kamtar/HotDogBalloon/hw/kicad_project/picoballoon.pdf

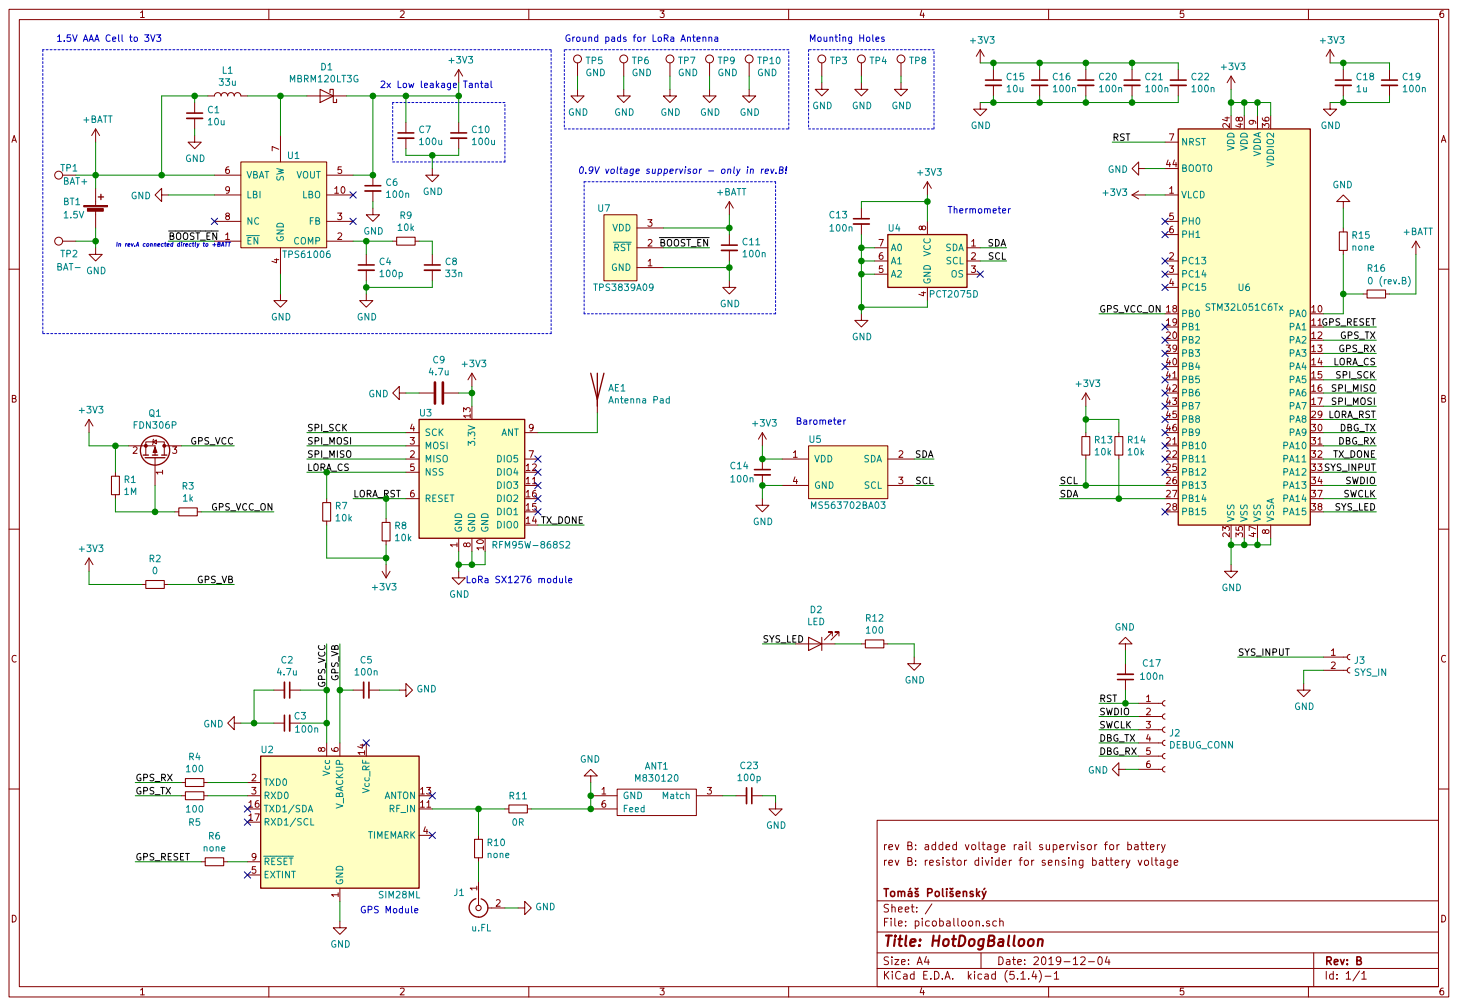
[picture p1: page 1]

9 VDDIO2 36 VLCD 1 VSS 23 VSS 35 VSS 47 VSSA

1 GND 10 DIO3 11 DIO4 12 3.3V 13 DIO0 14 DIO1 15 DIO2 16 MISO 2 MOSI 3 SCK 4 NSS 5 RESET 6 DIO5 7 GND

1 RF_IN 11 ANTON Vcc_RF 13 14 TXD1/SDA 16 RXD1/SCL 17 TXD0 2 RXD0 3 TIMEMARK 4 EXTINT 5 V_BACKUP

rev B: added voltage rail supervisor for battery GND

rev B: resistor divider for sensing battery voltage

File: picoballoon.sch Sheet: / Tomá Polienský
