kamtar/HotDogBalloon/hw/kicad_project/picoballoon.kicad_pcb

## KiCad design hw/kicad_project/picoballoon.kicad_pcb (2019-12-02)

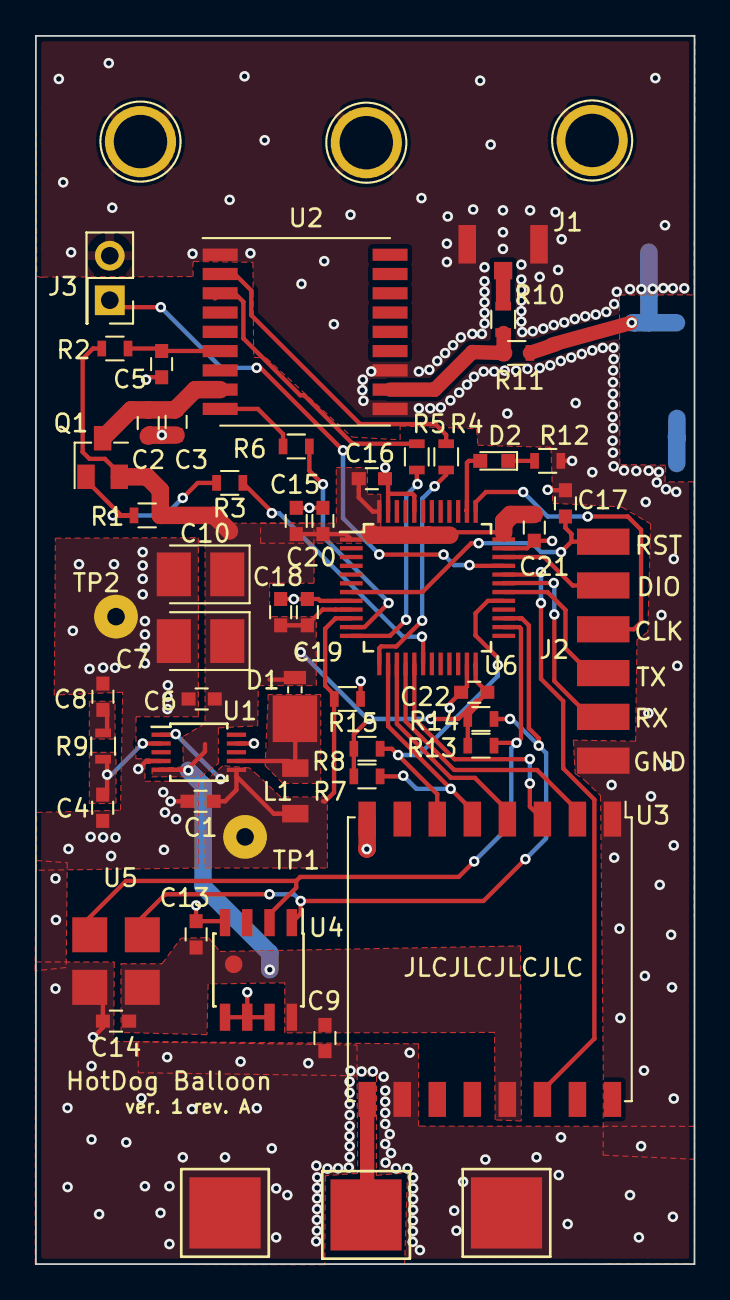
[picture p2: board picoballoon.kicad_pcb from above]

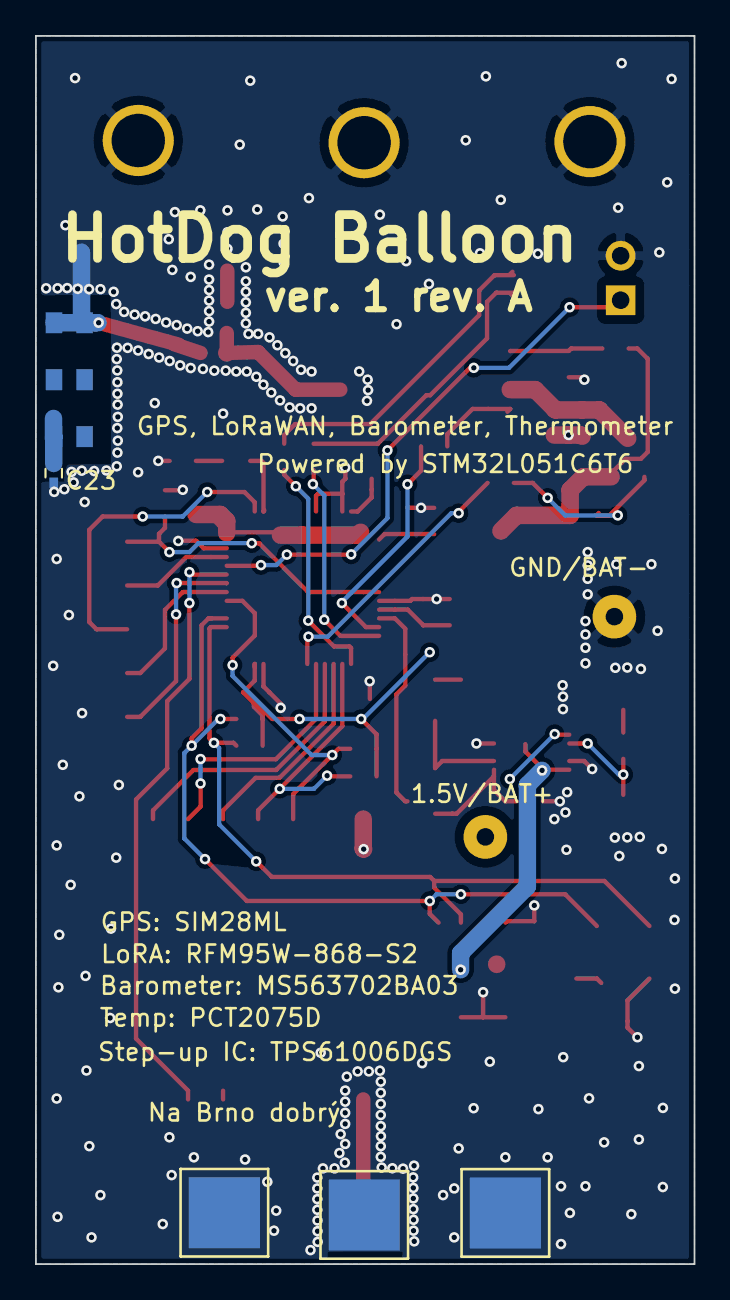
[picture p3: board picoballoon.kicad_pcb from below]

Board: 2 copper layers, 37.6 x 70.1 mm, 61 parts (5 on the bottom side), 36 nets.

Parts:
AE1: Antenna; 1Pin
ANT1: M830120
C1, C15: 10u; C_0603
C2, C9: 4.7u; C_0603
C3, C5, C6, C13, C14, C16, C17, C19, C20, C21, C22: 100n; C_0603
C4: 100p; C_0603
C7, C10: 100u; CP_Tantalum_Case-T_EIA-3528-12_Reflow
C8: 33n; C_0603
C18: 1u; C_0603
C23: 100p; C_0402
D1: MBRM120LT3G; D_Powermite_KA
D2: LED; LED_0603
J1: Conn_Coaxial; ufl
J2: DEBUG_CONN; DBG_CONN
J3: SYS_IN; Socket_Strip_Straight_2x01_Pitch2.54mm
L1: 33u; Inductor_2520
Q1: FDN306P; SuperSOT-3
R1: 1M; R_0603
R2: 0; R_0603
R3: 1k; R_0603
R4, R5: 100; R_0603
R6, R10, R15: none; R_0603
R7, R8, R9, R13, R14: 10k; R_0603
R11: 0R; R_0603
R12: 200; R_0603
TP1: BAT+; SolderWirePad_single_1mmDrill
TP2: BAT-; SolderWirePad_single_1mmDrill
TP3, TP4, TP8: DrillHole; 1pin
TP5, TP6, TP7, TP9, TP10: GND; 1Pin
U1: TPS61006; TSSOP-10_3x3mm_Pitch0.5mm
U2: SIM28ML
U3: RFM95W-868S2; HOPERF_RFM9XW_SMD
U4: PCT2075D; SOIC-8_3.9x4.9mm_Pitch1.27mm
U5: MS563702BA03; MS5637
U6: STM32L051C6Tx; LQFP-48_7x7mm_Pitch0.5mm

Connections:
+3V3: C6.1, C7.1, C9.1, C10.1, C13.1, C14.1, C15.1, C16.1, C18.1, C19.1, C20.1, C21.1, C22.1, D1.1, Q1.2, R1.1, R2.2, R7.2, R8.2, R13.1, R14.1, U1.5, U3.13, U4.8, U5.1, U6.1, U6.9, U6.24, U6.36, U6.48
/DBG_RX: J2.5, U6.31
/DBG_TX: J2.4, U6.30
/GPS_RESET: R6.2, U6.11
/GPS_RX: R4.2, U6.13
/GPS_TX: R5.2, U6.12
/GPS_VB: C5.2, R2.1, U2.6
/GPS_VCC: C2.1, C3.2, Q1.3, U2.8
/GPS_VCC_ON: R3.1, U6.18
/LORA_CS: R7.1, U3.5, U6.14
/LORA_RST: R8.1, U3.6, U6.29
/RST: C17.1, J2.1, U6.7
/SCL: R13.2, U4.2, U5.3, U6.26
/SDA: R14.2, U4.1, U5.2, U6.27
/SPI_MISO: U3.2, U6.16
/SPI_MOSI: U3.3, U6.17
/SPI_SCK: U3.4, U6.15
/SWCLK: J2.3, U6.37
/SWDIO: J2.2, U6.34
/SYS_INPUT: J3.1, U6.33
/SYS_LED: D2.2, U6.38
/TX_DONE: U3.14, U6.32
GND: ANT1.1, ANT1.6, C1.2, C2.2, C3.1, C4.2, C5.1, C6.2, C7.2, C8.2, C9.2, C10.2, C13.2, C14.2, C15.2, C16.2, C17.2, C18.2, C19.2, C20.2, C21.2, C22.2, C23.1, J1.2, J2.6, J3.2, R11.1, R12.1, R15.1, TP2.1, TP3.1, TP4.1, TP5.1, TP6.1, TP7.1, TP8.1, TP9.1, TP10.1, U1.4, U1.9, U2.1, U2.10, U2.12, U3.1, U3.8, U3.10, U4.4, U4.5, U4.6, U4.7, U5.4, U6.8, U6.23, U6.35, U6.44, U6.47
unnamed: AE1.1, U3.9
unnamed: ANT1.3, C23.2
unnamed: C4.1, R9.2, U1.2
unnamed: C8.1, R9.1
unnamed: D1.2, L1.2, U1.7
unnamed: D2.1, R12.2
unnamed: J1.1, R10.2
unnamed: Q1.1, R1.2, R3.2
unnamed: R4.1, U2.2
unnamed: R5.1, U2.3
unnamed: R6.1, U2.9
unnamed: R10.1, R11.2, U2.11
V_BATT: C1.1, L1.1, R15.2, TP1.1, U1.1, U1.6, U6.10
