kamtar/HotDogBalloon/firmware/hotdog_balloon.ioc

Mcu.UserName=STM32L051C6Tx
PA0.Signal=ADC_IN0
PA10.Signal=USART1_RX
PA13.Signal=SYS_SWDIO
PA14.Signal=SYS_SWCLK
PA2.Signal=USART2_TX
PA3.Signal=USART2_RX
PA5.Signal=SPI1_SCK
PA6.Signal=SPI1_MISO
PA7.Signal=SPI1_MOSI
PA9.Signal=USART1_TX
PB13.Signal=I2C2_SCL
PB14.Signal=I2C2_SDA
