kamtar/HotDogBalloon/firmware/Core/Inc/main.h

#ifndef __MAIN_H
#define __MAIN_H

#include "stm32l0xx_hal.h"
#include <stdbool.h>

#define delay_ms HAL_Delay

typedef struct
{
	uint32_t	latitude[2];
	uint8_t 	n_s;
	uint32_t	longitude[2];
	uint8_t		e_w;
	uint32_t	altitude[2];

}__attribute__ ((__packed__)) Position;

// ----------------------------------------------------------------------------
typedef struct
{
	uint32_t 	uptime;

	bool 		gps_fixed;
	bool		gps_valid;

	Position	gps_position;

	int32_t		temp;

}State_struct;

// ----------------------------------------------------------------------------
typedef struct
{
	volatile uint32_t red;

}Led_struct;

// ----------------------------------------------------------------------------
typedef struct
{
	volatile uint32_t ms;
	volatile uint32_t sys_uart_tmr;

}Ms_tmr_struct;

// ----------------------------------------------------------------------------
typedef struct
{
	volatile uint32_t sec;

}Sec_tmr_struct;

// ----------------------------------------------------------------------------
typedef struct
{
	volatile bool sec;
	volatile bool sys_uart_timeout;

}Flag_struct;

extern ADC_HandleTypeDef hadc;
extern CRC_HandleTypeDef hcrc;
extern RTC_HandleTypeDef hrtc;
extern SPI_HandleTypeDef hspi1;
extern UART_HandleTypeDef huart1;
extern UART_HandleTypeDef huart2;

extern State_struct		st;
extern Ms_tmr_struct 	ms_tmr;
extern Sec_tmr_struct 	sec_tmr;
extern Led_struct 		led;
extern Flag_struct		flags;

#ifdef __cplusplus
extern "C" {
#endif

void Error_Handler(void);

void systick_handler();

#ifdef __cplusplus
}
#endif

#endif /* __MAIN_H */

/************************ (C) COPYRIGHT STMicroelectronics *****END OF FILE****/
