kamtar/HotDogBalloon/firmware/Core/Src/uart.cpp

#include "uart.h"
#include "main.hpp"

#include "system_init.h"

static bool sys_uart_enabled = false;
static bool gps_uart_enabled = false;

// ----------------------------------------------------------------------------
bool enable_sys_uart(uint32_t timeout)
{
	bool was_disabled = !sys_uart_enabled;

	if(!sys_uart_enabled)
	{
		USART1_MUX(true);

		sys_uart.enable();

		sys_uart_enabled = true;
	}

	if(ms_tmr.sys_uart_tmr < timeout)
		ms_tmr.sys_uart_tmr = timeout;

	return was_disabled;
}

// ----------------------------------------------------------------------------
void disable_sys_uart(bool was_disabled)
{
	if(sys_uart_enabled && was_disabled)
	{
		sys_uart.disable();

		USART1_MUX(false);

		sys_uart_enabled = false;
	}
}

// ----------------------------------------------------------------------------
bool enable_gps_uart()
{
	bool was_disabled = !gps_uart_enabled;

	if(!gps_uart_enabled)
	{
		USART2_MUX(true);

		gps_uart.enable();

		gps_uart_enabled = true;
	}

	return was_disabled;
}

// ----------------------------------------------------------------------------
void disable_gps_uart(bool was_disabled)
{
	if(gps_uart_enabled && was_disabled)
	{
		gps_uart.disable();

		USART2_MUX(false);

		gps_uart_enabled = false;
	}
}
