kamtar/HotDogBalloon/(commit log)

2019-02-02 generated some more code from stm gen code thingy (mainly SPI and AES) started fork on semtech126x added lorawanstack added dataref stuff
2019-11-27 cmake attempt and new hardware in kicad
    [picoballoon-B_Cu.gbr, picoballoon-B_Mask.gbr, picoballoon-B_SilkS.gbr, picoballoon-Edge_Cuts.gbr, picoballoon-F_Cu.gbr, picoballoon-F_Mask.gbr, picoballoon-F_SilkS.gbr, picoballoon-NPTH-drl_map.gbr]
2019-12-02 minor consmetic changes
    [picoballoon.kicad_pcb, picoballoon.sch]
2019-12-04 schematics rev.B
    [picoballoon.sch]
2019-12-04 bug R16 none -> 0
    [picoballoon.sch]
2019-12-09 deleted old project and added new one for stm32l0
2019-12-18 added lora driver
2019-12-27 Zakomentovano pouziti GPS Zmena hlavnich hodin z PLL na HSI 16 MHz Po inicializaci SX1276 prechod do STANDBY a nasledne do SLEEP WAIT nebo STOP na konci hlavni smycky RTC wakeup kazdou sekundu, blikn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
2020-01-12 Inicialiace externi flash, vycteni ID a write enable, priprava driveru
2020-01-25 Prikazy na systemovem UARTu k ovladani externi flash.
2020-01-25 Oprava probouzeni na spravne hodiny Definice timeoutu pro sys UART - po resetu 30s, prodluzovani pri komunikaci Zapinani/vypinani rozhrani UART1, SPI1
    [Commands.cpp, STM32FIFOUART.cpp, STM32FIFOUART.h, config.h, debug.cpp, main.cpp, main.h, spi.cpp]
